AlexanderFurman/Final-Project/Demos/88c7a752-df2d-4189-9e73-a354138ea98a.jpg

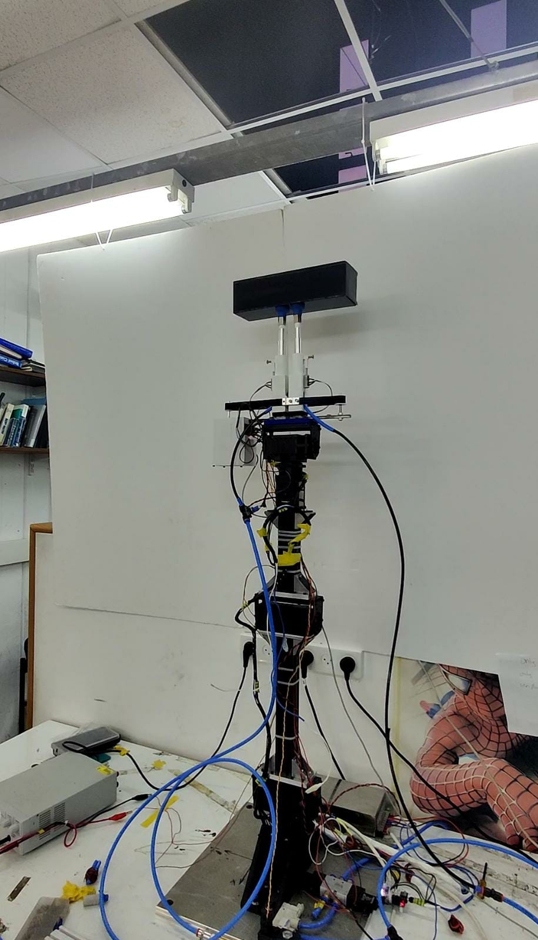
Demos/88c7a752-df2d-4189-9e73-a354138ea98a.jpg
