AlexanderFurman/Final-Project/Presentation/Alexander Furman Final Project Presentation.pptx

## Sensor integrated vacuum gripper

Alex Furman under supervision of prof. Rimon

Digital Connections

## Semester 1: Project description

- Create gripper with vacuum tech
- Integrate with ROS

Initial ideas

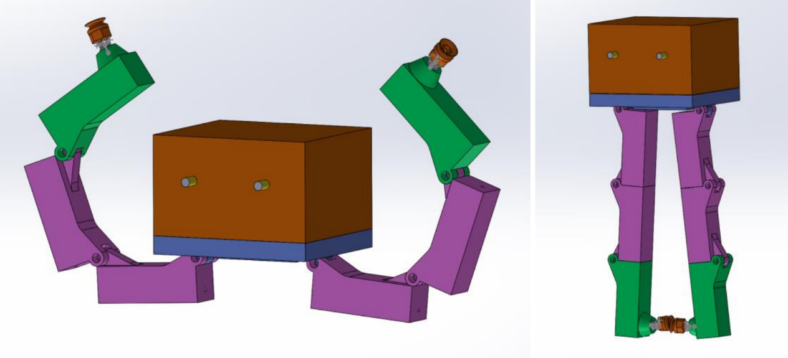
[picture p3: figure]

Final Product

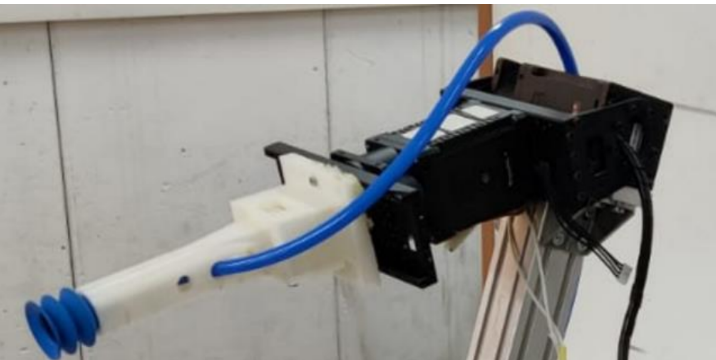
[picture p4: figure]
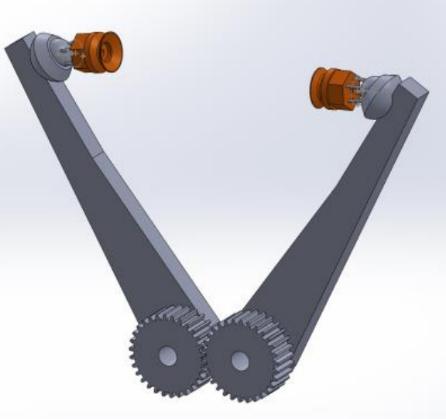
[picture p5: figure]
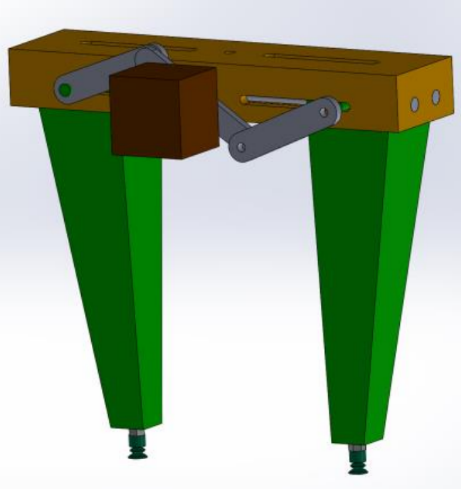
[picture p6: figure]

## Semester 1: System description

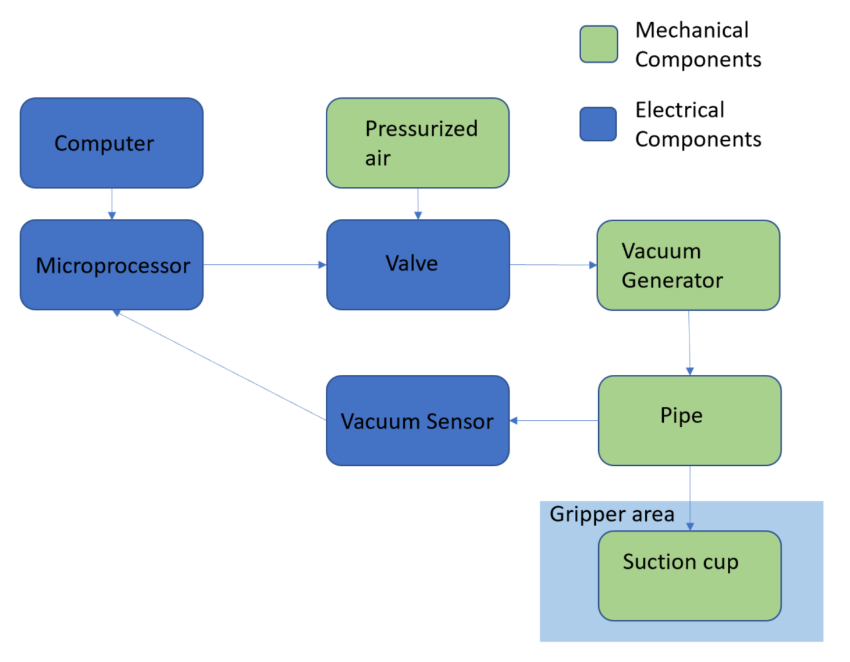
[picture p7: figure]

## Semester 1: design strengths + weaknesses

- Strengths:
  - Very compact
  - Strong suction
- Weaknesses:
  - Only handles smooth surfaces well
  - Requires very accurate placement
  - Does not handle torques well at suction cup

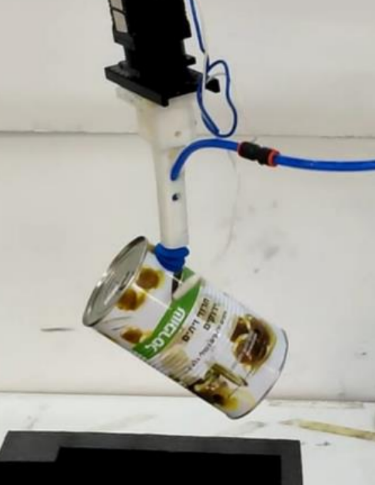
[picture p8: figure]

## Semester 2: Project description

  - Minimize design weaknesses
  - Improve gripper placement given inaccuracies in Computer Vision

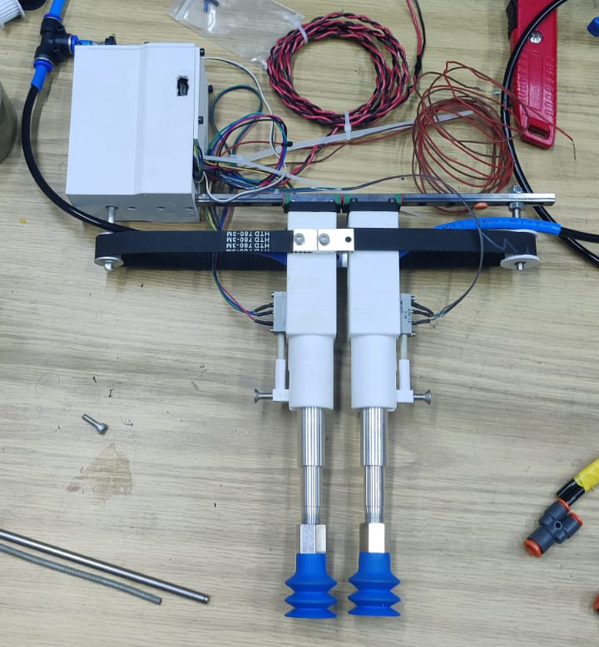
[picture p9: figure]
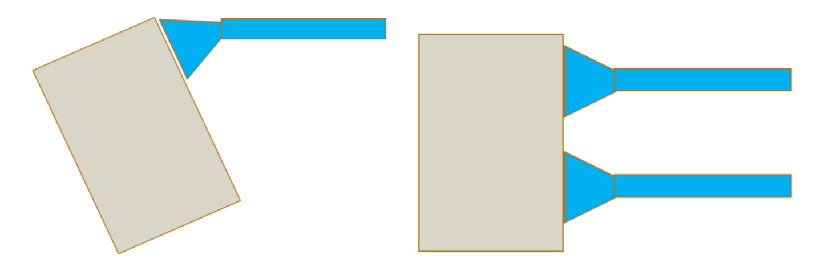
[picture p10: figure]
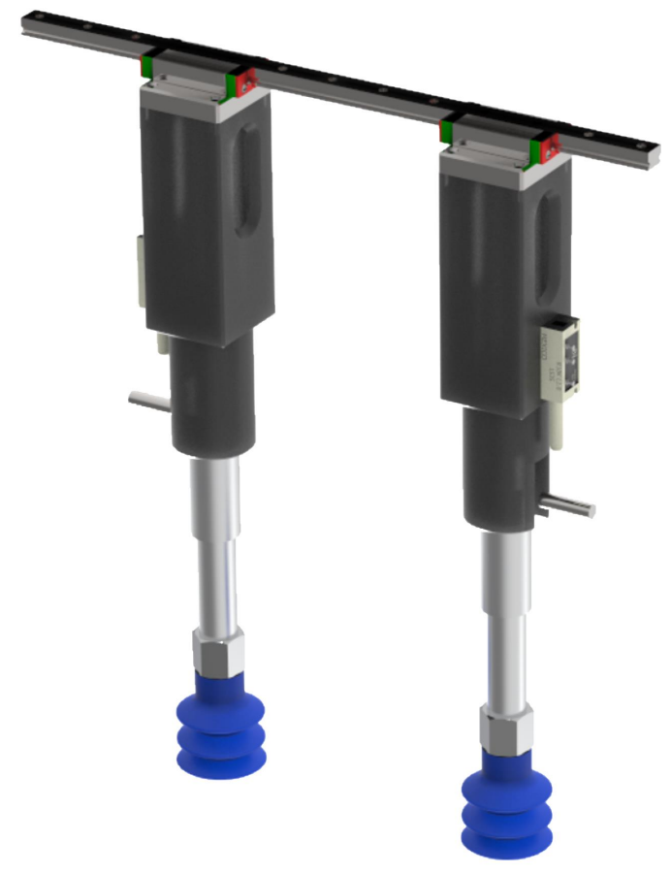
[picture p11: figure]
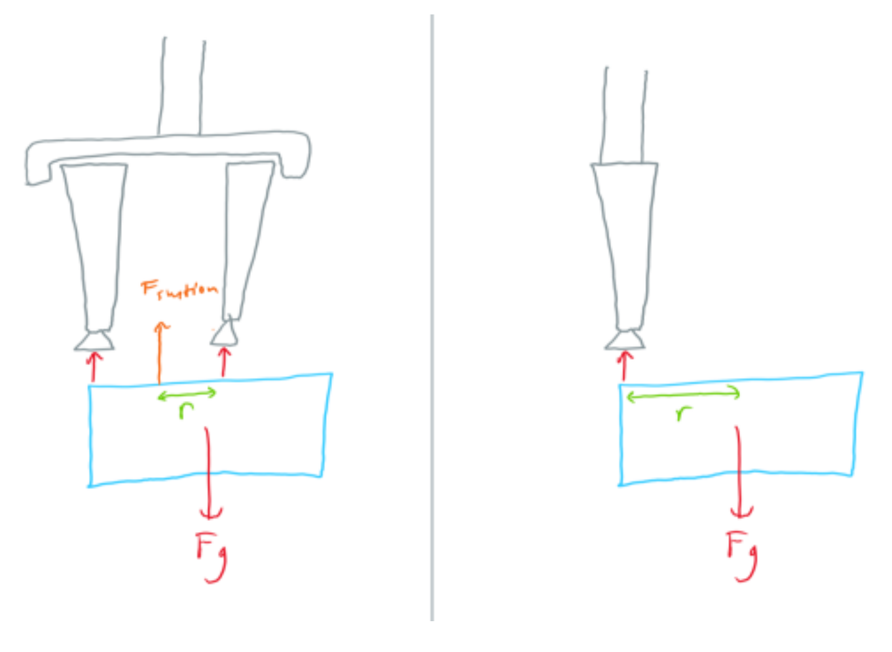
[picture p12: figure]

## Semester 2: Illustrations

  - Finger Design

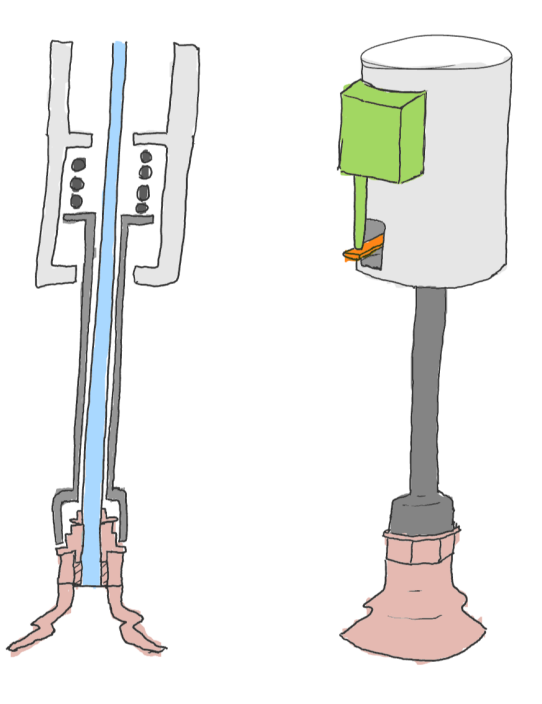
[picture p13: figure]

Belt Driven vs Lead-screw Driven

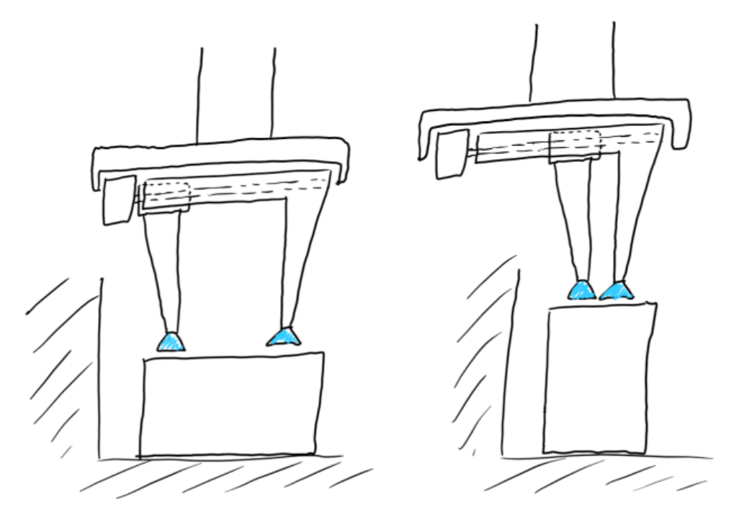
[picture p14: figure]
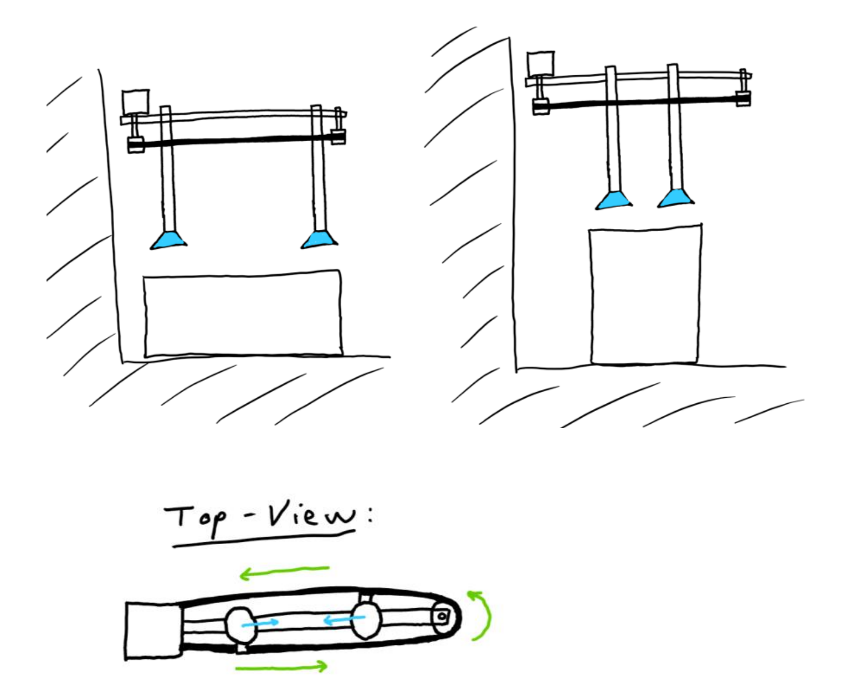
[picture p15: figure]

## Semester 2: design strengths + weaknesses

- Strengths:
  - Addresses torque issue from previous design
  - Now possible to create correction algorithms due to the potentiometers
- Weaknesses:
  - Force produced in each finger effectively halved (only one vacuum generator)
  - Bigger than last design
  - A lot more mechanical parts + electronics – harder maintenance
- Notes:
  - More testing should be done to determine if extra vacuum generator is necessary
  - Some components of the design can be improved in later iterations

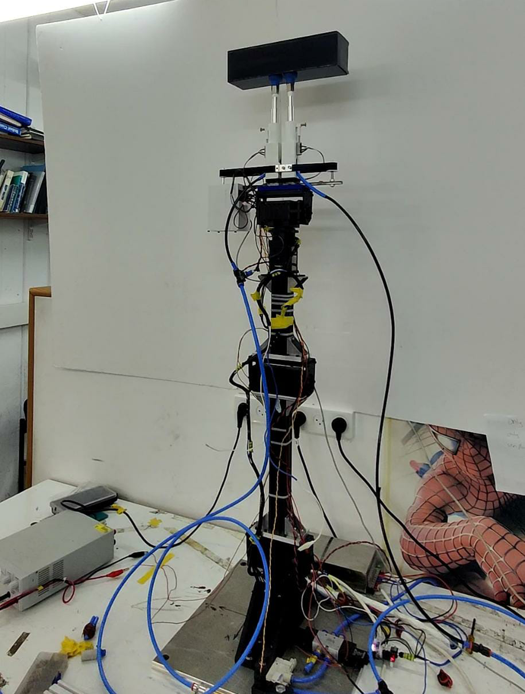
[picture p16: figure]

## Future work: algorithms

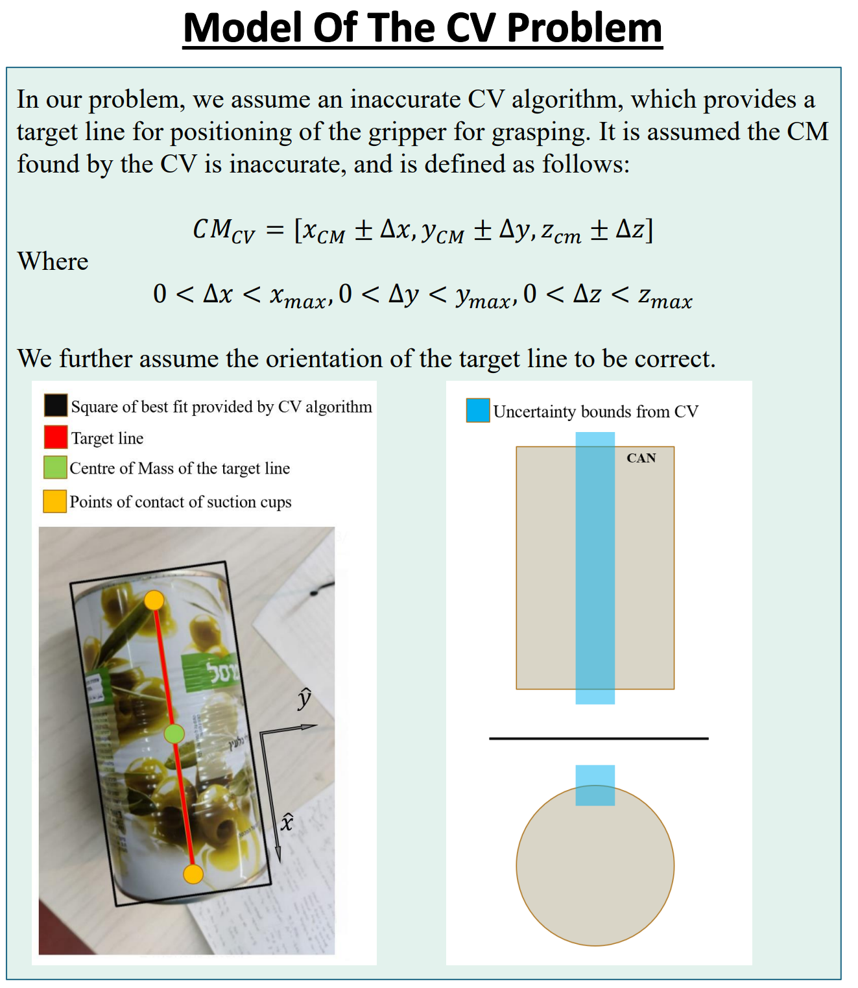
[picture p17: figure]
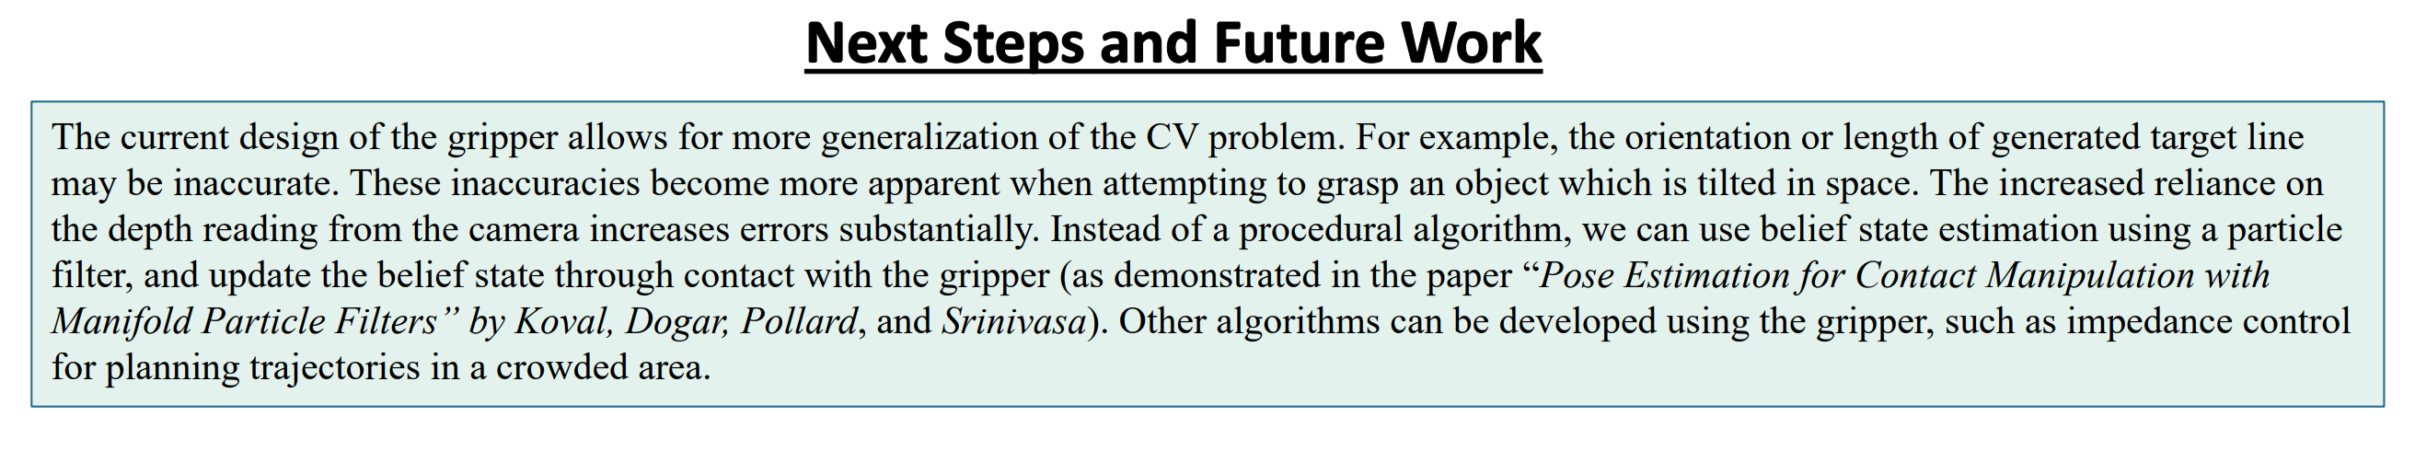
[picture p18: figure]
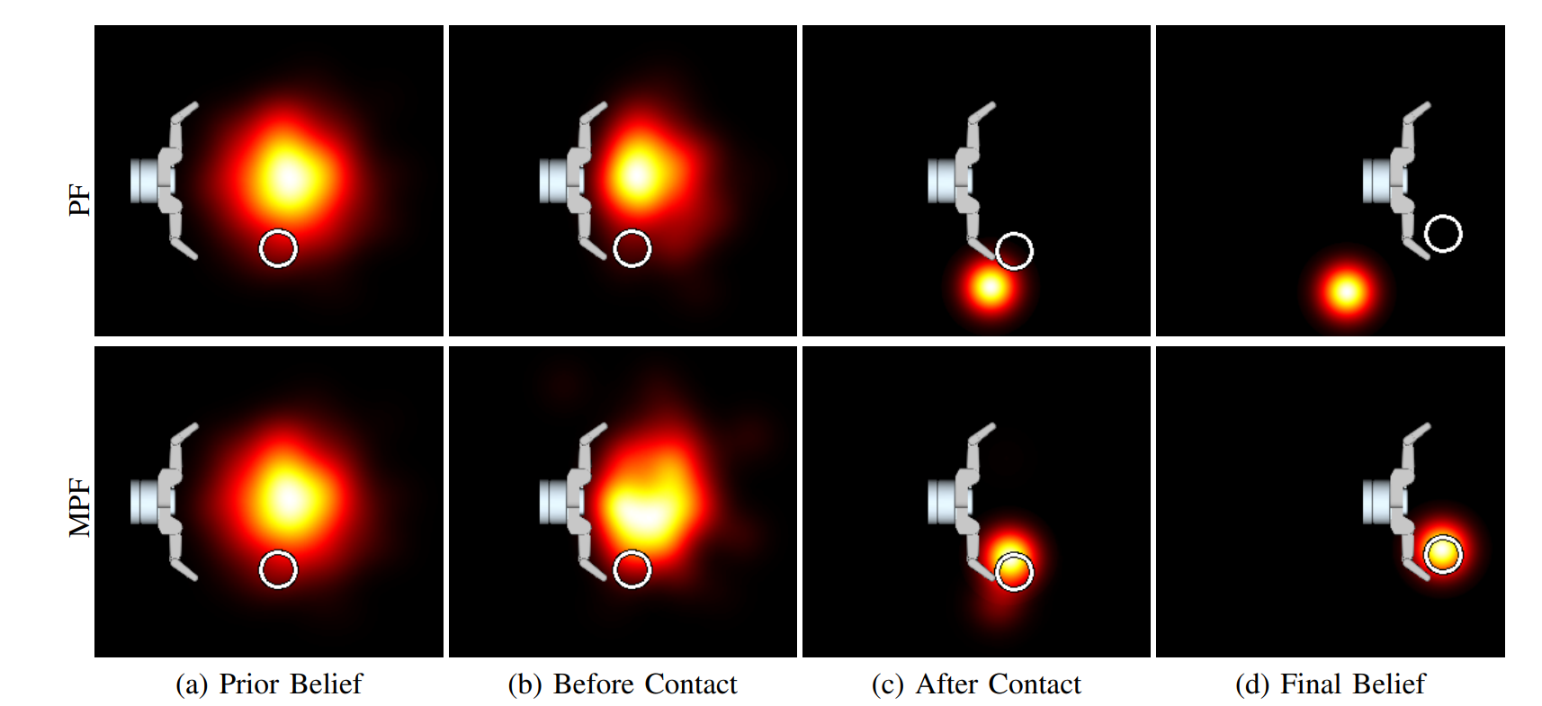
[picture p19: figure]
