AlexanderFurman/Final-Project/Electronics/Alex Furman - Electronics PDF.pdf

# Computer

# Pressurized

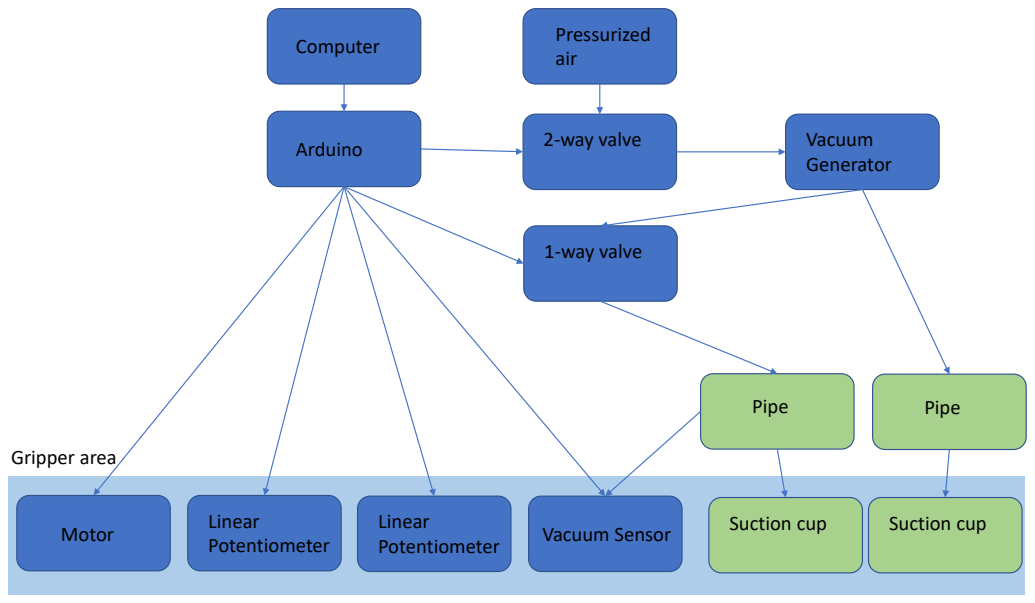
[picture p20: page 1]
air; Arduino; Linear Potentiometer; Linear; Potentiometer; Vacuum Sensor; Vacuum Generator; 2-way valve; 1-way valve; Suction cup; Gripper area; Motor; Pipe

# Gripper Schematic

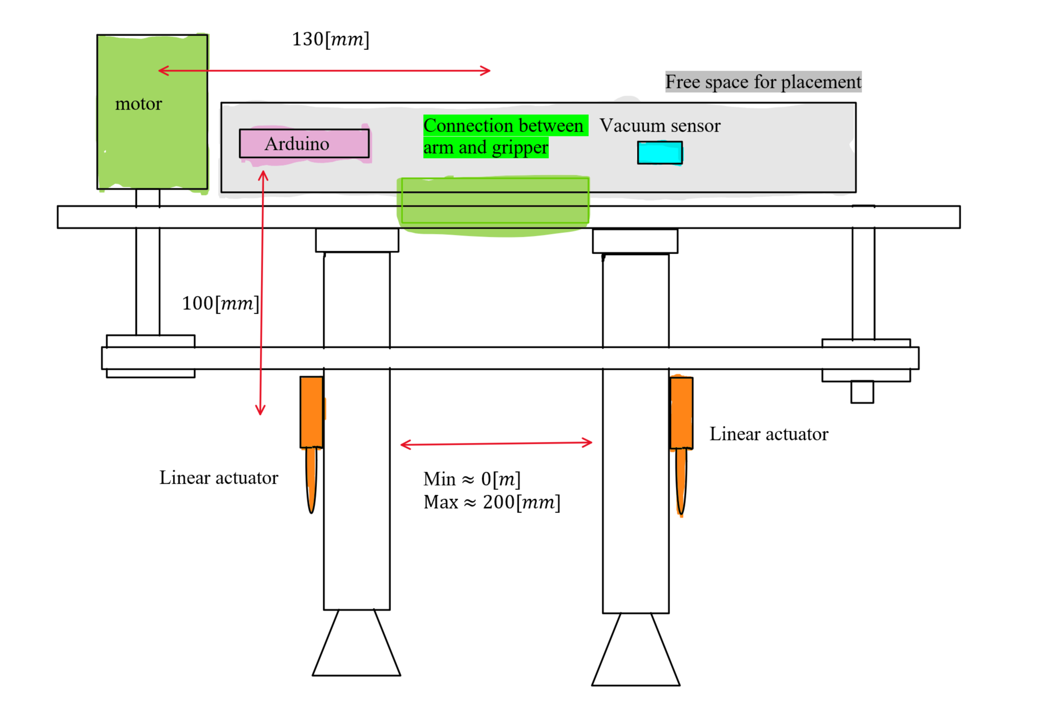
[picture p21: page 2]

# PCB casing dimensions

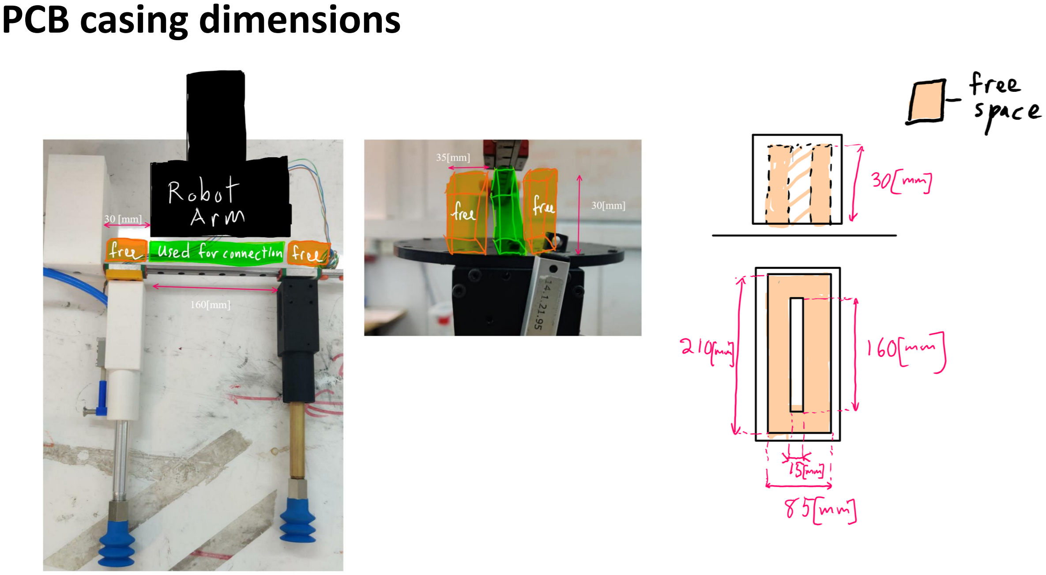
[picture p22: page 3]

# 2-way valve

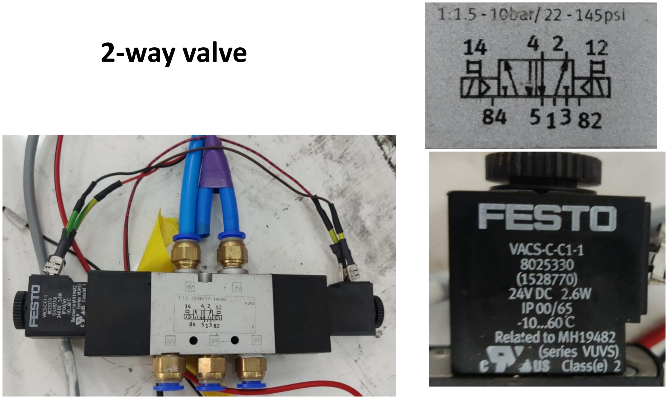
[picture p23: page 4]

# 1-way valve

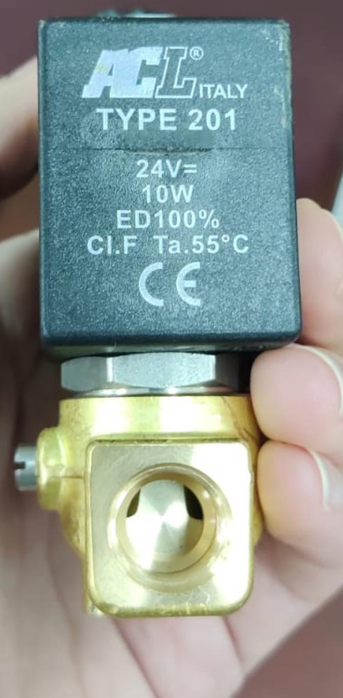
[picture p24: figure]
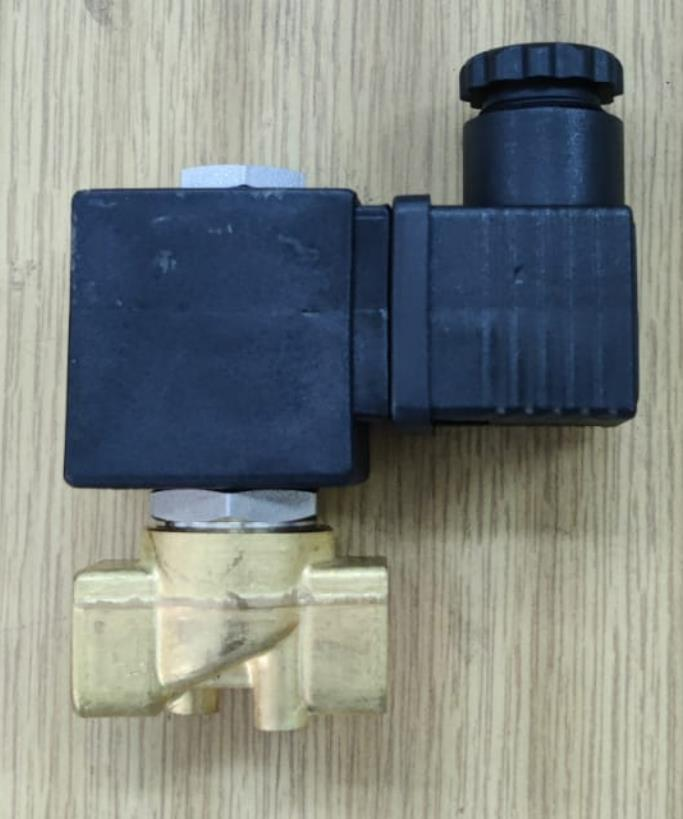
[picture p25: figure]

# Linear potentiometer

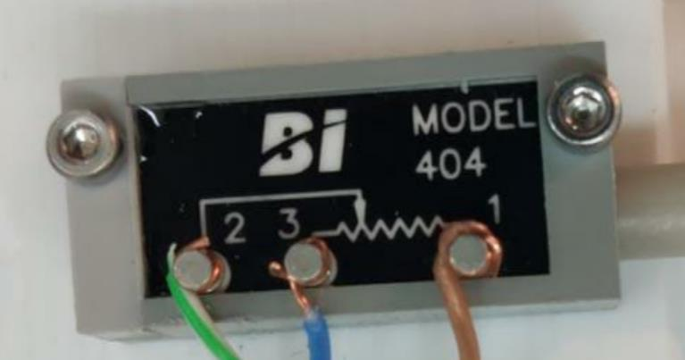
[picture p26: figure]

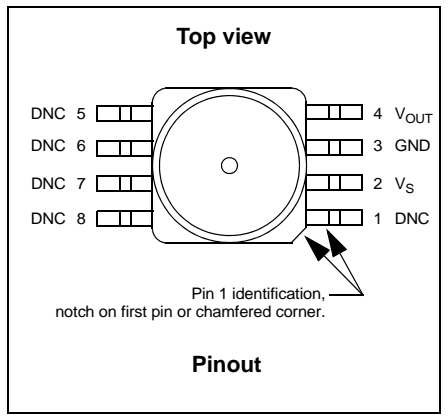
[picture p27: figure]
Top view; Pinout; Pin 1 identification, notch on first pin or chamfered corner.; DNC; GND; VOUT

Freescale reserves the right to change the detail specifications as may be required to permit improvements in the design of its products.

Freescale Semiconductor | Document Number: MPXV6115V
Data Sheet: Technical Data | Rev. 4.0, 09/2015

© 2009-2013, 2015 Freescale Semiconductor, Inc. All rights reserved.

MPXV6115V, -115 to 0 kPa, Gauge,

# and Absolute Pressure Sensor

The MPXV6115V series sensor integrates on-chip, bipolar op-amp circuitry and thin film resistor networks to provide a high output signal and temperature compensation. The small form factor and high reliability of on-chip integration make this pressure sensor a logical and economical choice for the system designer.
The MPXV6115V series piezoresistive transducer is a state-of-the-art, monolithic, signal conditioned, silicon pressure sensor. This sensor combines advanced micromachining techniques, thin film metallization, and bipolar semiconductor processing to provide an accurate, high level analog output signal that is proportional to applied pressure.
Features
- Improved accuracy at high temperature
- 1.5% maximum error from 0 to 85 °C
- Ideally suited for microprocessor- or microcontroller-based systems
- Temperature compensated from -40 to +125 °C
- Durable thermoplastic surface mount package
Typical applications
- Vacuum pump monitoring
- Brake booster monitoring

Ordering information
Device name | Shipping | Package | # of Ports | Pressure Type | Device Marking
None | Single | Dual | Gauge | Differential | Absolute
Small Outline Package
MPXV6115V6U | Rail | 98ASB17756C | • | | Vacuum/ Gauge | MPXV6115V
MPXV6115V6T1 | Tape and Reel | 98ASB17756C | • | | Vacuum/ Gauge | MPXV6115V
MPXV6115VC6U | Rail | 98ASB17757C | | • | Vacuum/ Gauge | MPXV6115V

# MPXV6115V

Small outline package

MPXV6115VC6U
Case 98ASB17757C

MPXV6115V6U/6T1
Case 98ASB17756C

MPXV6115V

Sensors
2 | Freescale Semiconductor, Inc.

## Related Documentation

The MPXV6115V device features and operations are described in a variety of reference manuals, user guides, and application notes. To find the most-current versions of these documents:
1. Go to the Freescale homepage at:
http://www.freescale.com/
2. In the Keyword search box at the top of the page, enter the device number MPXV6115V.
3. In the Refine Your Result pane on the left, click on the Documentation link.

## Contents

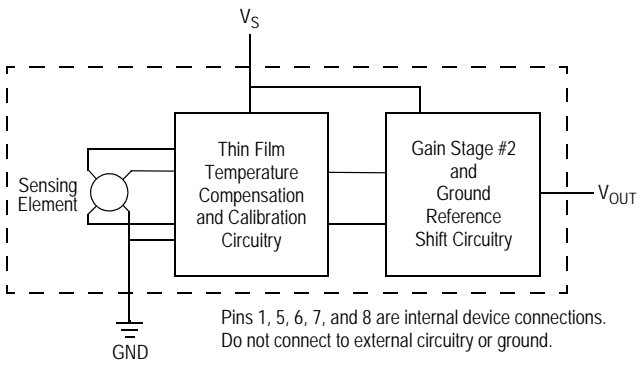
[picture p28: figure]
VOUT; Sensing Element; GND; Thin Film Temperature Compensation and Calibration Circuitry; Gain Stage #2 and Ground Reference Shift Circuitry

Freescale Semiconductor, Inc. | 3

## 1 General Description

## 1.1 Block diagram

Figure 1 shows a block diagram of the internal circuitry integrated on a pressure sensor chip.

Figure 1. Integrated pressure sensor block diagram

## 1.2 Pinout

Figure 2. Device pinout (top view)

Table 1. Pin functions

Pin | Name | Function
1 | DNC | Do not connect to external circuitry or ground. Pin 1 is notated by the notch in the lead or chamfered corner.
2 | VS | Voltage supply
3 | GND | Ground
4 | VOUT | Output voltage
5 | DNC | Do not connect to external circuitry or ground.
6 | DNC | Do not connect to external circuitry or ground.
7 | DNC | Do not connect to external circuitry or ground.
8 | DNC | Do not connect to external circuitry or ground.

Pins 1, 5, 6, 7, and 8 are internal device connections. Do not connect to external circuitry or ground.

Pin 1 identification,
notch on first pin or chamfered corner.

1

2

3

5 | 4

6

7

8

DNC

DNC

DNC | DNC
DNC | VS GND

VOUT

4 | Freescale Semiconductor, Inc.

## 2 Mechanical and Electrical Specifications

## 2.1 Maximum ratings

## 2.2 Operating characteristics

Table 2. Maximum ratings⁽¹⁾

1. Exposure beyond the specified limits may cause permanent damage or degradation to the device.
Parametrics | Symbol | Value | Units
Maximum pressure (P1 > P2) | Pmax | 400 | kPa
Storage temperature | Tstg | -40 to +125 | °C
Operating temperature | TA | -40 to +125 | °C
Output source current @ full-scale output⁽²⁾ | Io+ | 0.5 | mAdc
Output sink current @ minimum pressure offset⁽²⁾ | Io- | -0.5 | mAdc
2. Maximum output current is controlled by effective impedance from VOUT to GND or VOUT to VS in the application circuit.

Table 3. Operating characteristics (VS = 5.0 VDC, TA = 25 °C unless otherwise noted, P1 > P2.)

Characteristic | Symbol | Min | Typ | Max | Unit
Pressure range | POP | –115 | — | 0 | kPa
Supply voltage⁽¹⁾ | VS | 4.75 | 5.0 | 5.25 | VDC
Supply current | Io | — | 6.0 | 10 | mAdc
Full-scale output⁽²⁾ (0 to 85 °C), @ VS = 5.0 Volts | VFSO | 4.534 | 4.6 | 4.665 | VDC
Full-scale span⁽³⁾ (0 to 85 °C), @ VS = 5.0 Volts | VFSS | — | 4.4 | — | VDC
Accuracy⁽⁴⁾ (0 to 85 °C) | — | — | — | ±1.5 | %VFSS
Sensitivity | V/P | — | 38.26 | — | mV/kPa
Response time⁽⁵⁾ | tR | — | 1.0 | — | ms
Warm-up time⁽⁶⁾ | — | — | 20 | — | ms
Offset stability⁽⁷⁾ | — | — | ±0.5 | — | %VFSS
1. Device is ratiometric within this specified excitation range.
2. Full-scale output (VFSO) is defined as the output voltage at the maximum or full rated pressure.
3. Full-scale span (VFSS) is defined as the algebraic difference between the output voltage at full rated pressure and the output voltage at the minimum rated pressure.
4. Accuracy is the deviation in actual output from nominal output over the entire pressure range and temperature range as a percent of span at 25 °C due to all sources of error including the following:
Linearity: Output deviation from a straight line relationship with pressure over the specified pressure range.
Temperature hysteresis:Output deviation at any temperature within the operating temperature range, after the temperature is cycled to and from the minimum or maximum operating temperature points, with zero differential pressure applied. Pressure hysteresis: Output deviation at any pressure within the specified range, when this pressure is cycled to and from minimum or maximum rated pressure at 25 °C
TcSpan: Output deviation over the temperature range of 0 to 85 °C, relative to 25 °C.
TcOffset: Output deviation with minimum pressure applied, over the temperature range of 0 to 85 °C, relative to 25 °C.
5. Response time is defined as the time for the incremental change in the output to go from 10% to 90% of its final value when subjected to a specified step change in pressure.
6. Warm-up time is defined as the time required for the product to meet the specified output voltage after the pressure has been stabilized.
7. Offset stability is the product's output deviation when subjected to 1000 cycles of Pulsed Pressure, Temperature Cycling with Bias Test.

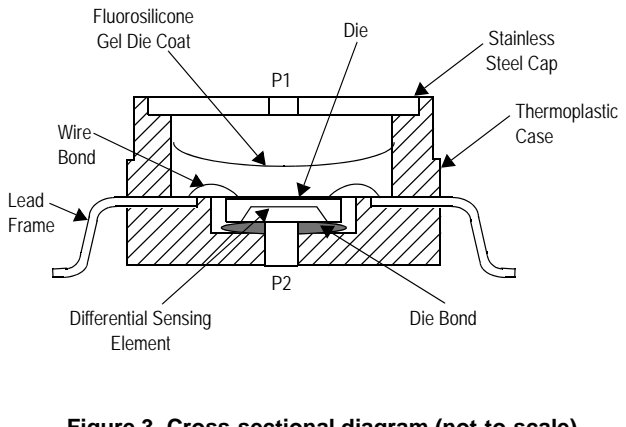
[picture p29: figure]
Fluorosilicone Gel Die Coat; Differential Sensing Element; Stainless Steel Cap P1; Die Bond; Die; Thermoplastic Case; Lead Frame; Wire Bond
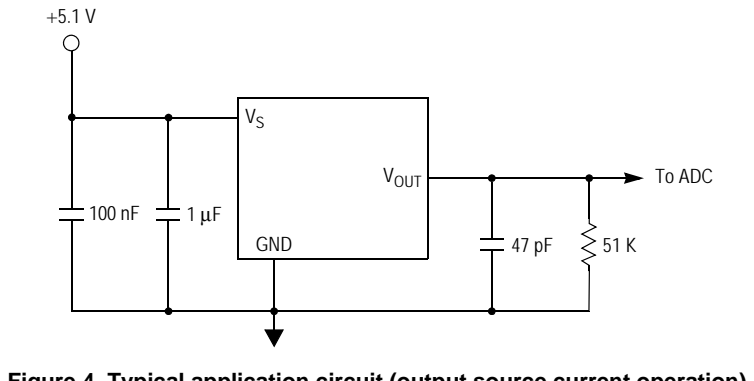
[picture p30: figure]
GND; VOUT; To ADC

Freescale Semiconductor, Inc. | 5

## 3 On-chip Temperature Compensation and Calibration

Figure 3 illustrates the absolute sensing chip in the basic small outline chip carrier ().
Figure 4 shows a typical application circuit (output source current operation).
Figure 5 shows the sensor output signal relative to pressure input. Typical minimum and maximum output curves are shown for operation over 0 to 85 °C temperature range. The output will saturate outside of the rated pressure range.
A fluorosilicone gel isolates the die surface and wire bonds from the environment, while allowing the pressure signal to be transmitted to the silicon diaphragm. The MPXV6115V series pressure sensor operating characteristics, internal reliability and qualification tests are based on use of dry air as the pressure media. Media other than dry air may have adverse effects on sensor performance and long-term reliability. Contact the factory for information regarding media compatibility in your application.
The MPXV6115V is optimized to perform in vacuum pressures applied to port P1. The sensor is calibrated and temperature compensated to give a positive electrical output upon measuring a vacuum pressure up to the rated pressure of up to -115 kPa where the output will be the full-scale voltage listed in Table 3.

Figure 3. Cross-sectional diagram (not-to-scale)

Figure 4. Typical application circuit (output source current operation)

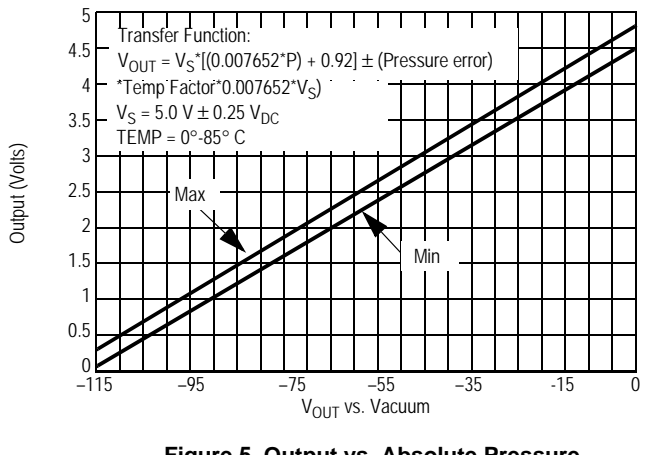
[picture p31: figure]
Transfer Function:; VOUT vs. Vacuum; Output (Volts); TEMP = 0°-85° C; Min; Max

6 | Freescale Semiconductor, Inc.

Figure 5. Output vs. Absolute Pressure

Figure 6. Transfer function

Figure 7. Temperature error band

Figure 8. Pressure error band

VOUT = VS*[(0.007652*P) + 0.92] ± (Pressure error) *Temp Factor*0.007652*VS) VS = 5.0 V ± 0.25 VDC

Nominal Transfer Value: VOUT = VS x (0.007652 x P + 0.92) ± (Pressure Error x Temp. Factor x 0.007652 x VS) VS = 5.0 ± 0.25 VDC

Temperature in °C

4.0

3.0

2.0

0.0

1.0

-40 | -20 | 0 | 20 | 40 | 60 | 13012010080
–40 | 3
0 to 85 | 1
125 | 2

NOTE: The temperature multiplier is a linear response from 0 to –40 °C and from 85 to 125 °C.

140

Temp. Multiplier

Pressure in kPa
(below atmospheric)

1.950

1.725

1.500

-1.500

-1.725

-1.950

0
-115 | -100 | -85 | -45 | -30 | -15 | 0

Pressure Error (kPa)

Pressure Error (max)

Error Limits for Pressure

-115 to 0 kPa ± 1.725 kPa

-1.500

## 4 Package Information

## 4.1 Minimum recommended footprint for surface mounted applications

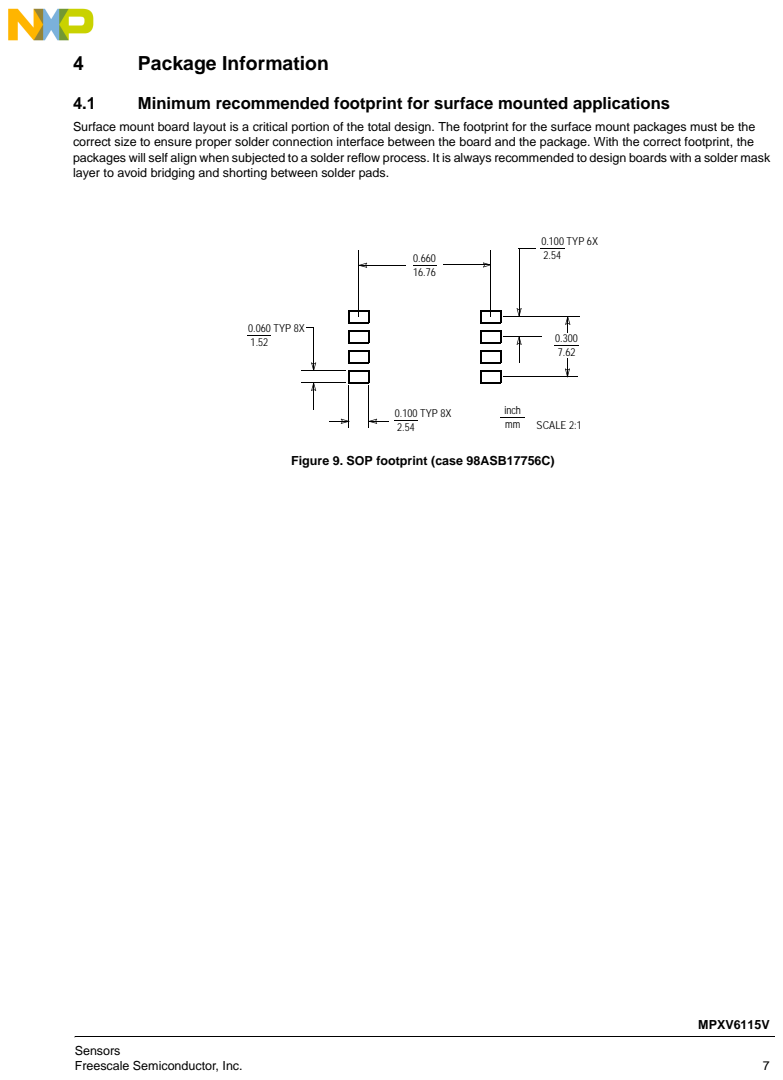
[picture p32: page 13]
Freescale Semiconductor, Inc.; 0.060 TYP 8X 1.52; 0.100 TYP 8X 2.54; 0.100 TYP 6X 2.54; inch mm SCALE 2:1

Surface mount board layout is a critical portion of the total design. The footprint for the surface mount packages must be the
correct size to ensure proper solder connection interface between the board and the package. With the correct footprint, the
packages will self align when subjected to a solder reflow process. It is always recommended to design boards with a solder mask
layer to avoid bridging and shorting between solder pads.

Figure 9. SOP footprint (case 98ASB17756C)

## 4.2 Package Dimensions

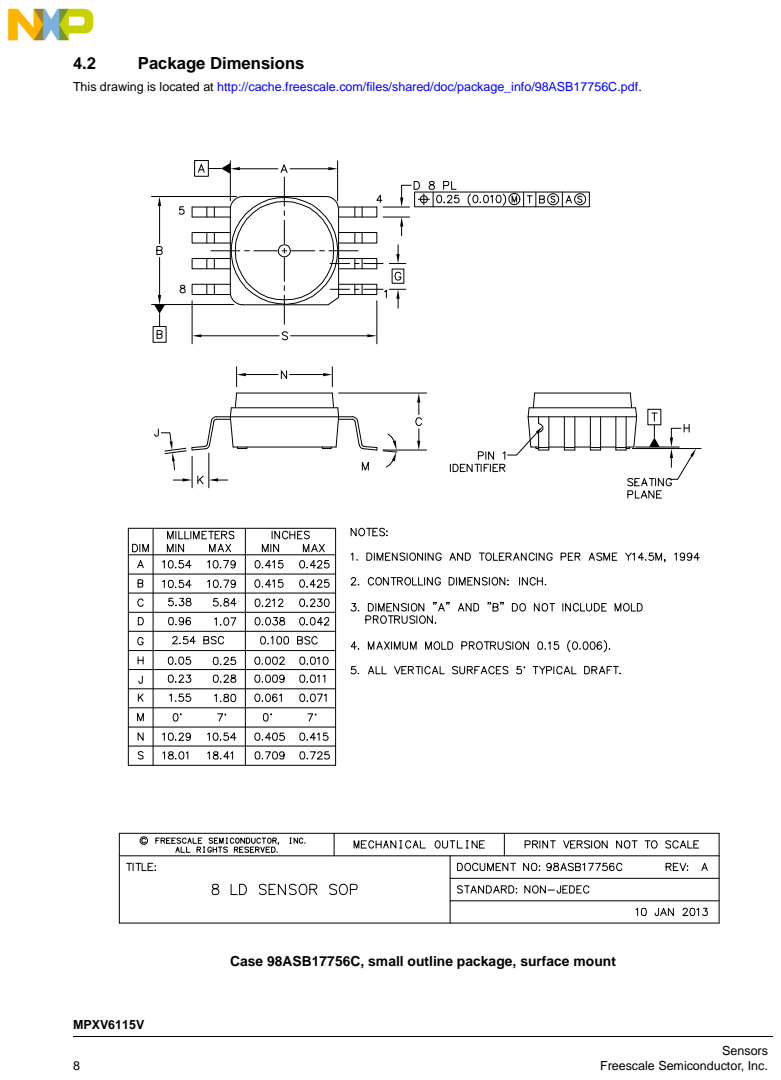
[picture p33: page 14]
Freescale Semiconductor, Inc.

This drawing is located at http://cache.freescale.com/files/shared/doc/package_info/98ASB17756C.pdf.

Case 98ASB17756C, small outline package, surface mount

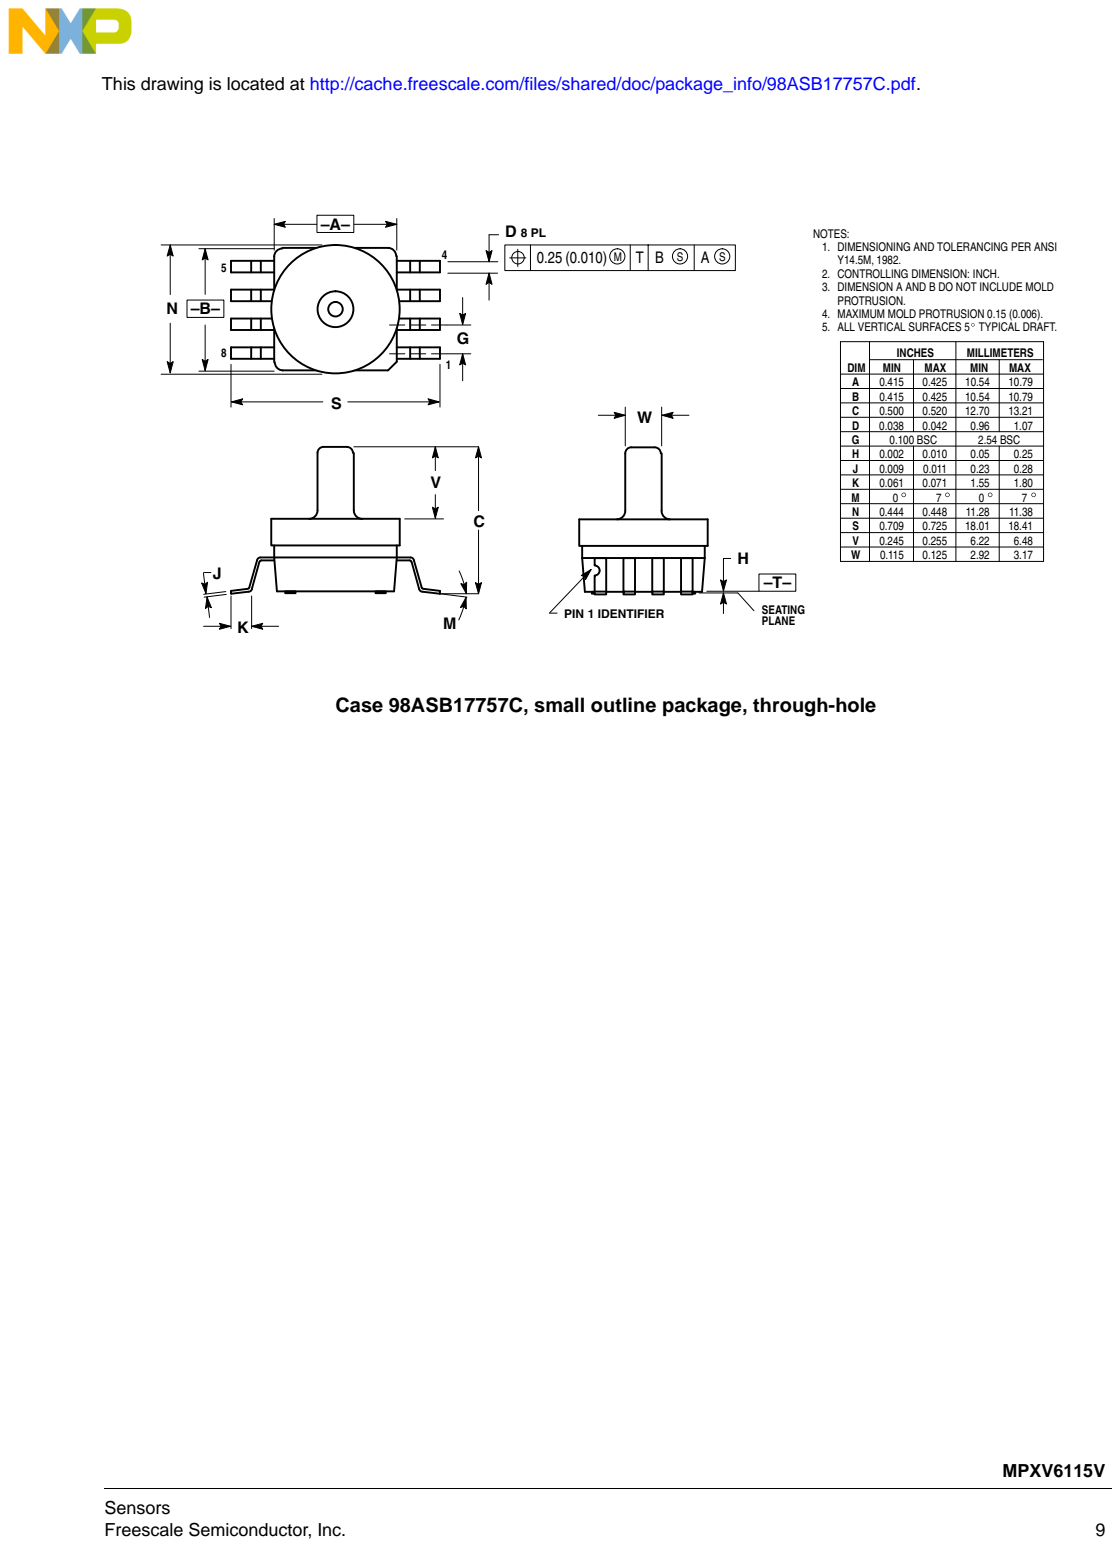
[picture p34: page 15]
Freescale Semiconductor, Inc.; K PIN 1 IDENTIFIER; SEATING PLANE

This drawing is located at http://cache.freescale.com/files/shared/doc/package_info/98ASB17757C.pdf.

NOTES:
1. DIMENSIONING AND TOLERANCING PER ANSI
2. CONTROLLING DIMENSION: INCH.
3. DIMENSION A AND B DO NOT INCLUDE MOLD
PROTRUSION.
4. MAXIMUM MOLD PROTRUSION 0.15 (0.006).
5. ALL VERTICAL SURFACES 5 TYPICAL DRAFT.

DIM | INCHES | MILLIMETERS
MIN | MAX | MIN | MAX
A | 0.415 | | 10.54 | 10.79 0.425
B | 0.415 | | 10.54 | 10.79 0.425
C | 0.500 | | 12.70 | 13.21 0.520
D | 0.038 | | 0.96 | 1.07 0.042
G | 0.100 BSC | | 2.54 BSC
H | 0.002 | 0.010 | 0.05 | 0.25
J | 0.009 | 0.011 | 0.23 | 0.28
K | 0.061 | 0.071 | 1.55 | 1.80
N | 0.444 | 0.448 | 11.28 | 11.38
S | 0.709 | 0.725 | 18.01 | 18.41
V | 0.245 | 0.255 | 6.22 | 6.48
W | 0.115 | 0.125 | 2.92 | 3.17

Case 98ASB17757C, small outline package, through-hole

10 | Freescale Semiconductor, Inc.

## 5 Revision History

Table 4. Revision history

Revision number | Revision date | Description of changes
2 | 10/2012 | • Added devices MPXB611V6U and MPX6115V6T1 and corresponding package, 482.
3 | 01/2013 | • Corrected psi range on page 1, device description box
4.0 | 09/2015 | • Updated format. • Corrected figure 4. • Added vacuum pressure information to section 3. • Updated case outline 98ASB17756C with current version. • Deleted obsolete device MPXV6115VC6T1.

Document Number: MPXV6115V Rev. 4.0
09/2015

Information in this document is provided solely to enable system and software

implementers to use Freescale products. There are no express or implied copyright

licenses granted hereunder to design or fabricate any integrated circuits based on the

information in this document.

Freescale reserves the right to make changes without further notice to any products

herein. Freescale makes no warranty, representation, or guarantee regarding the

suitability of its products for any particular purpose, nor does Freescale assume any

liability arising out of the application or use of any product or circuit, and specifically

disclaims any and all liability, including without limitation consequential or incidental

damages. “Typical” parameters that may be provided in Freescale data sheets and/or

specifications can and do vary in different applications, and actual performance may

vary over time. All operating parameters, including “typicals,” must be validated for each

customer application by customer’s technical experts. Freescale does not convey any

license under its patent rights nor the rights of others. Freescale sells products pursuant

to standard terms and conditions of sale, which can be found at the following address:

freescale.com/salestermsandconditions.

How to Reach Us:

Home Page:
freescale.com

Web Support:
freescale.com/support

Freescale and the Freescale logo are trademarks of Freescale Semiconductor, Inc.,

Reg. U.S. Pat. & Tm. Off. All other product or service names are the property of their

respective owners.

© 2009-2013, 2015 Freescale Semiconductor, Inc.
