AlexanderFurman/Final-Project/Electronics/Alex Furman - Electronics.pdf

Computer; Pressurized air; Arduino; Linear Potentiometer; Linear; Potentiometer; Vacuum Sensor; Vacuum Generator; 2-way valve; 1-way valve; Suction cup; Gripper area; Motor; Pipe

# Gripper Schematic


# PCB casing dimensions


# 2-way valve


# 1-way valve


# Linear potentiometer
