AlexanderFurman/Final-Project/Presentation/final_presentation.pdf

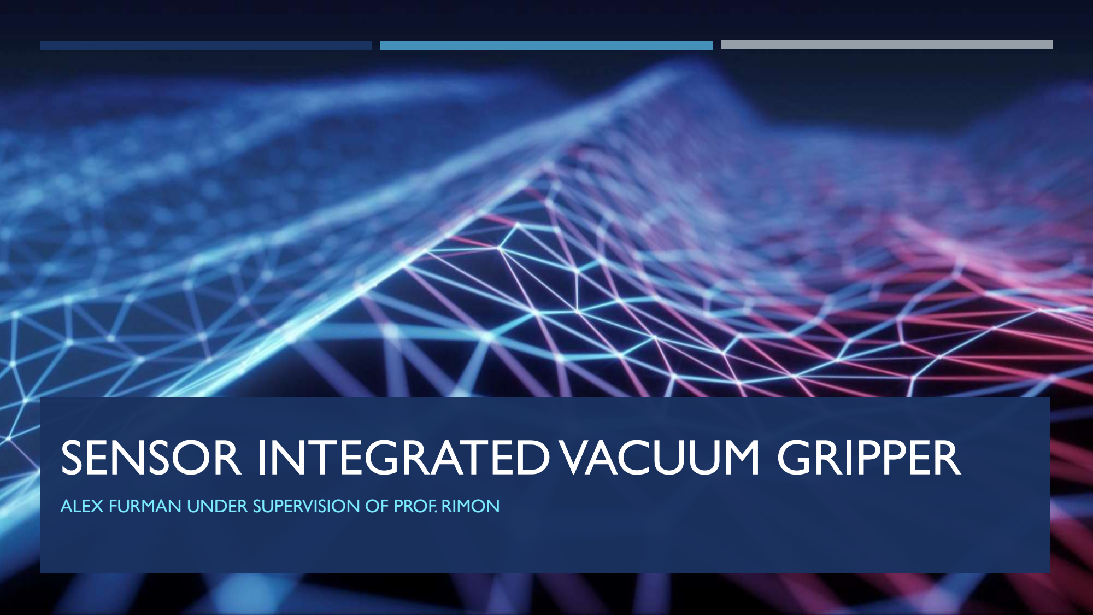
[picture p35: page 1]

# SENSOR INTEGRATED VACUUM GRIPPER

ALEX FURMAN UNDER SUPERVISION OF PROF. RIMON

# SEMESTER 1: PROJECT DESCRIPTION

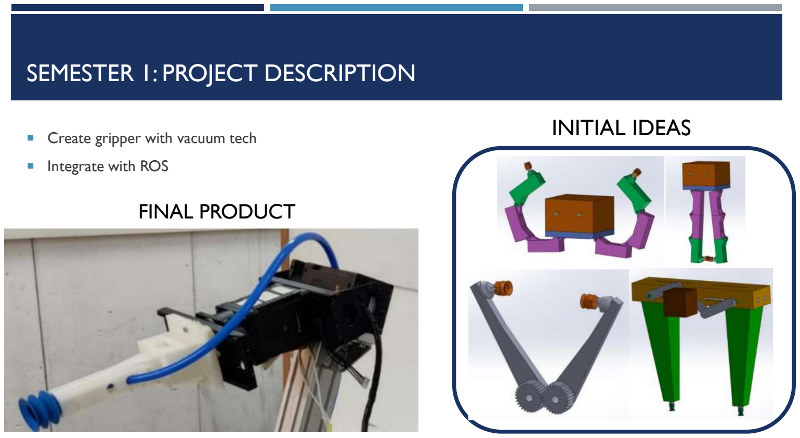
[picture p36: page 2]

- Create gripper with vacuum tech
- Integrate with ROS

## INITIAL IDEAS

## FINAL PRODUCT

# SEMESTER 1: SYSTEM DESCRIPTION

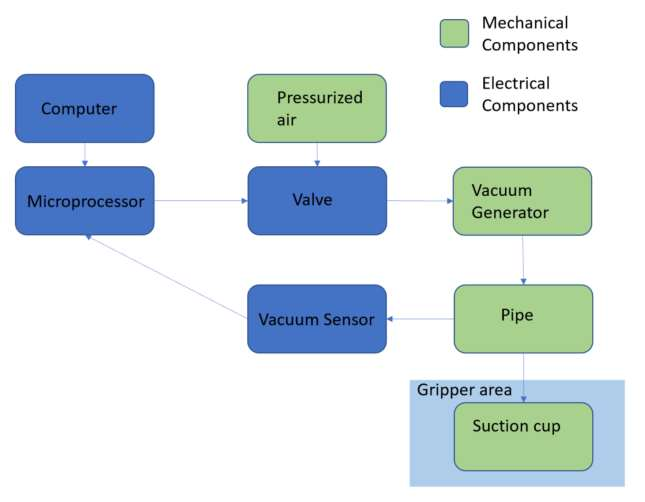
[picture p37: figure]

# SEMESTER 1: DESIGN STRENGTHS + WEAKNESSES

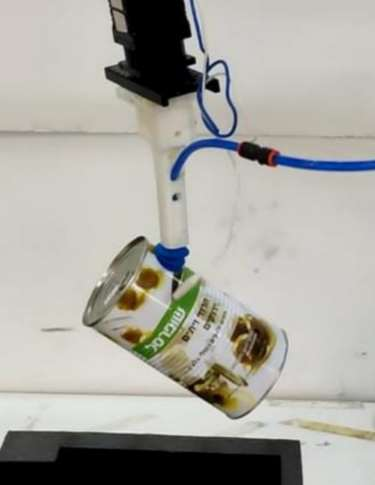
[picture p38: figure]

- Strengths:
- Very compact
- Strong suction
- Weaknesses:
- Only handles smooth surfaces well
- Requires very accurate placement
- Does not handle torques well at suction cup

# SEMESTER 2: PROJECT DESCRIPTION

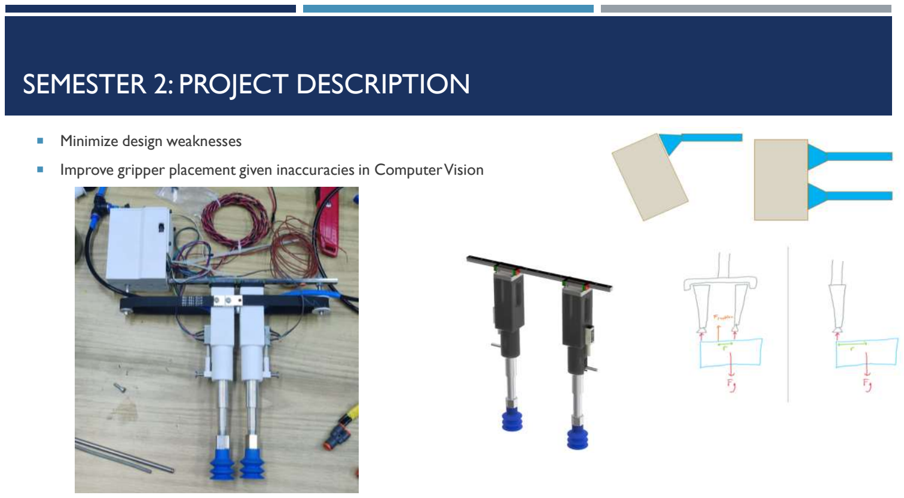
[picture p39: page 5]

- Minimize design weaknesses
- Improve gripper placement given inaccuracies in Computer Vision

# SEMESTER 2: ILLUSTRATIONS

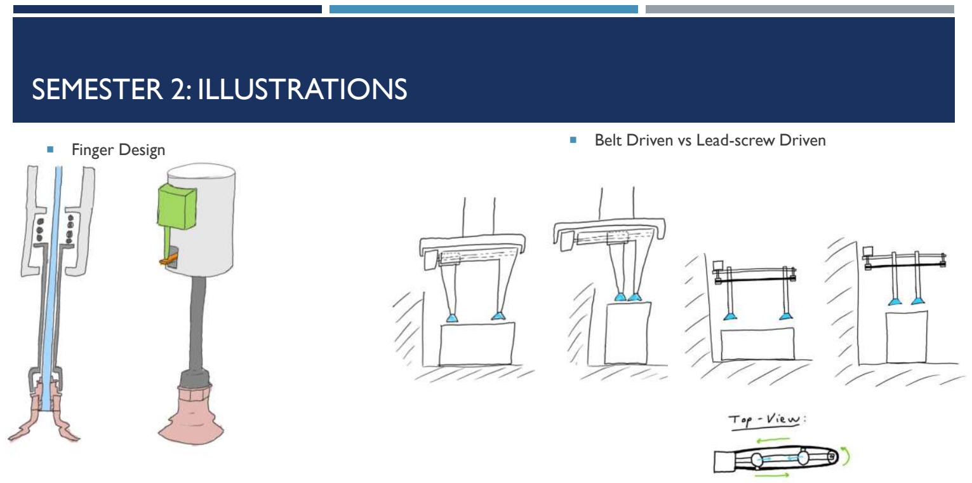
[picture p40: page 6]

- Finger Design
- Belt Driven vs Lead-screw Driven

# SEMESTER 2: DESIGN STRENGTHS + WEAKNESSES

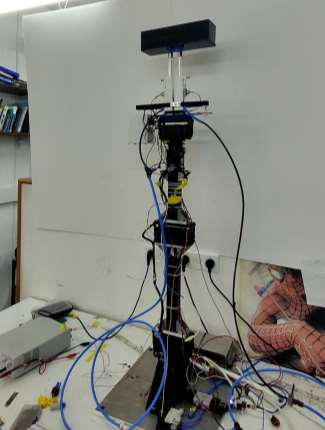
[picture p41: figure]

- Strengths:
- Addresses torque issue from previous design
- Now possible to create correction algorithms due to the potentiometers
- Weaknesses:
- Force produced in each finger effectively halved (only one vacuum generator)
- Bigger than last design
- A lot more mechanical parts + electronics – harder maintenance
- Notes:
- More testing should be done to determine if extra vacuum generator is necessary
- Some components of the design can be improved in later iterations

# FUTURE WORK: ALGORITHMS

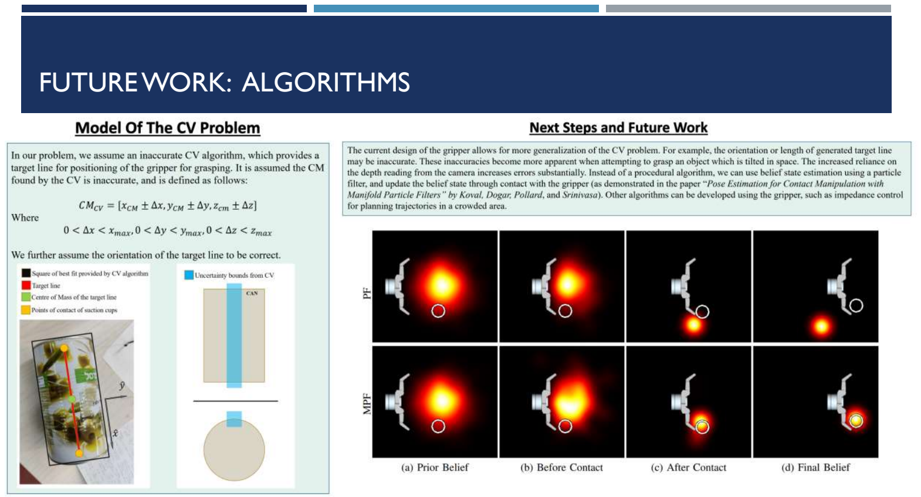
[picture p42: page 8]
