AlexanderFurman/Final-Project/Research/Doc2.docx

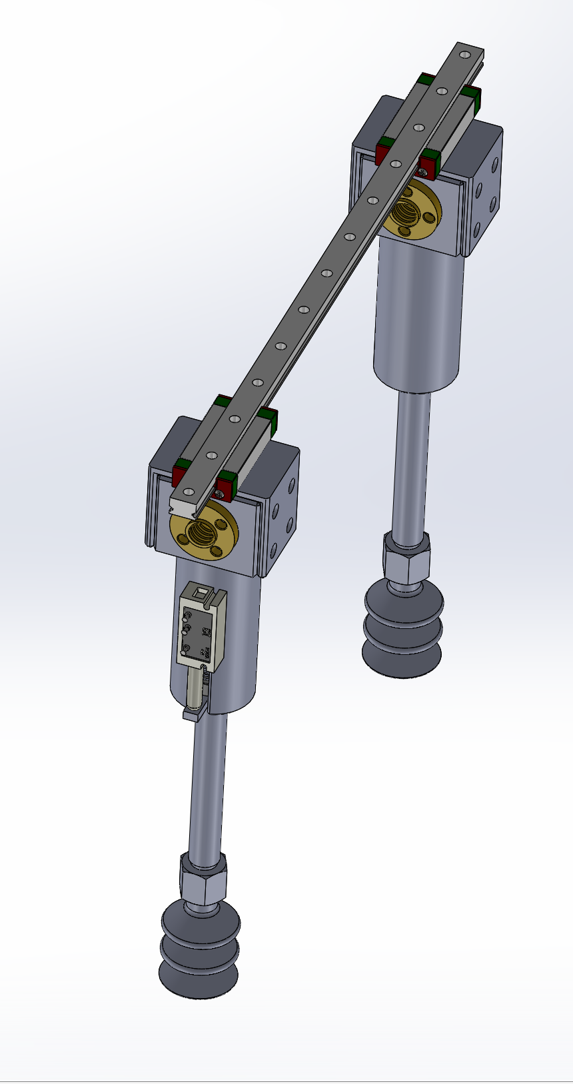
[picture p43: figure]
