AlexanderFurman/Final-Project/Research/Doc1.pdf

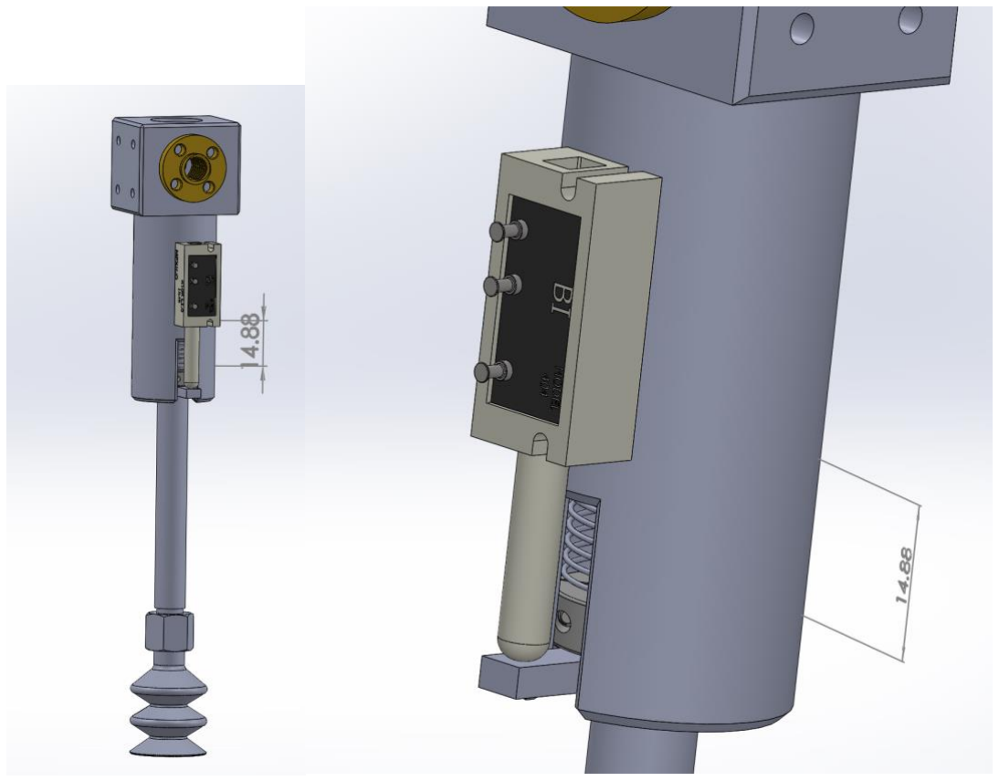
[picture p44: figure]

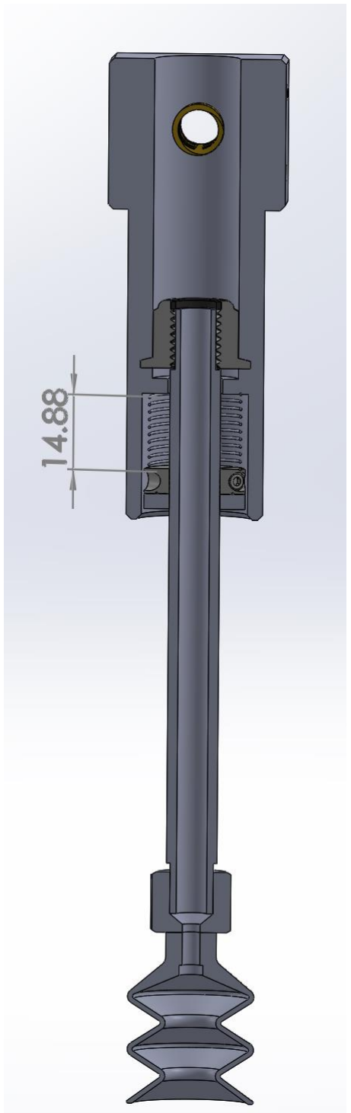
[picture p45: figure]
