AlexanderFurman/Final-Project/Electronics/Circuitry.pdf

## 24 Volt

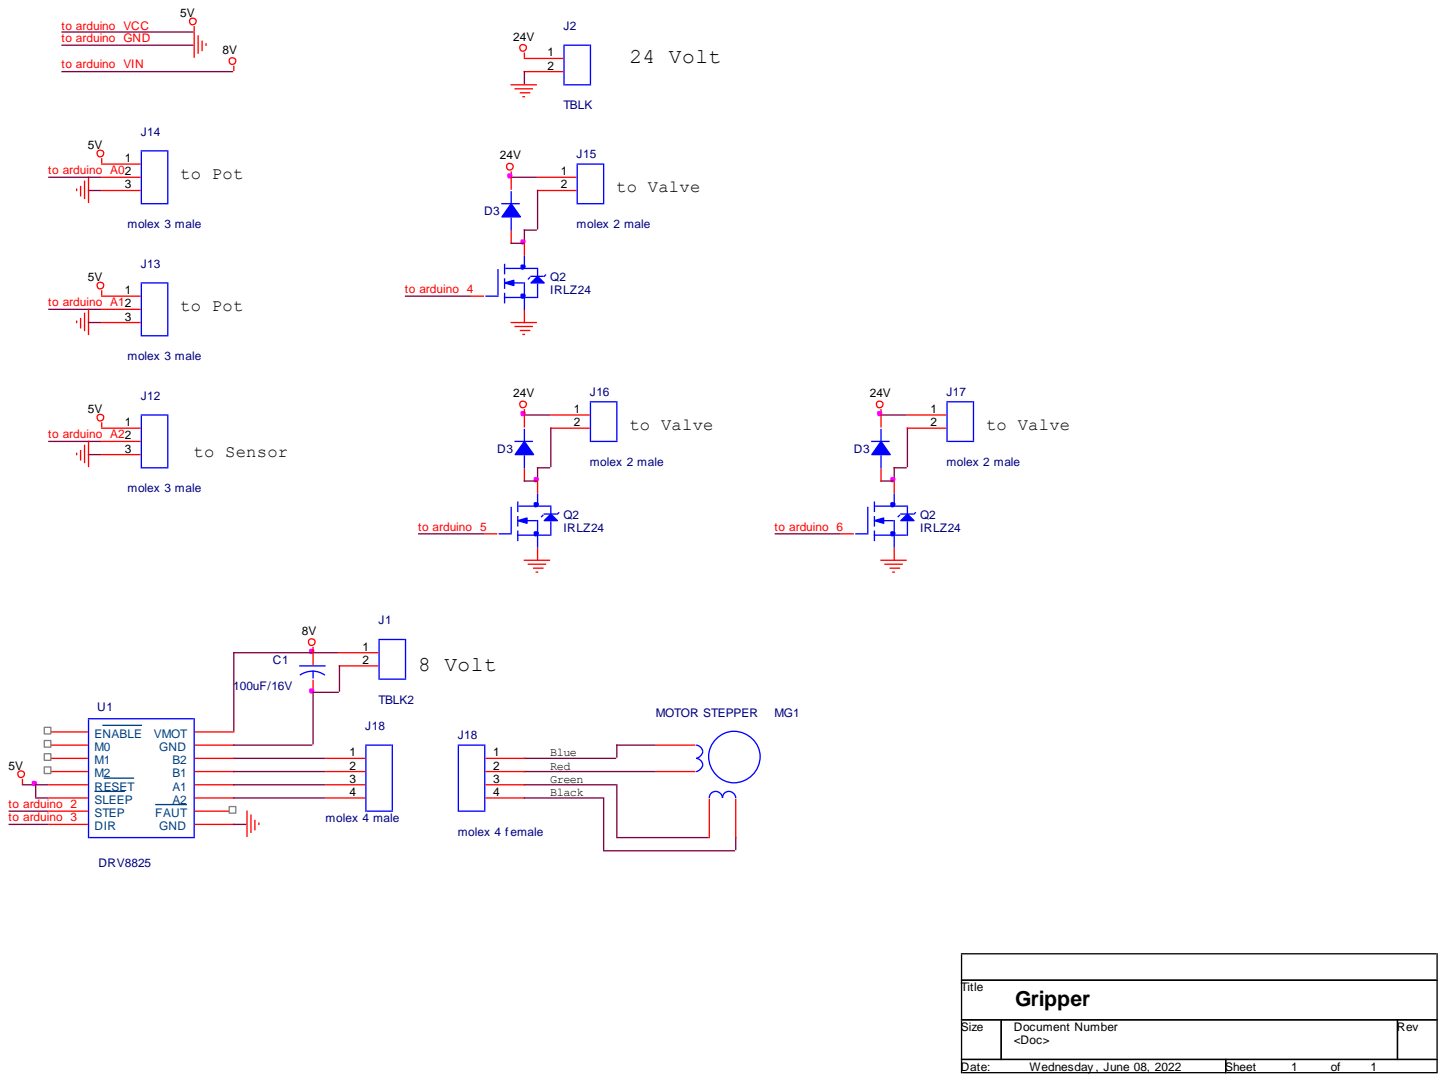
[picture p46: page 1]

Size | Document Number <Doc> | Rev

Date: Wednesday , June 08, 2022 | Sheet 1 of 1
