AlexanderFurman/Final-Project/Manufacturing/A3 Vacuum Rod New.pdf

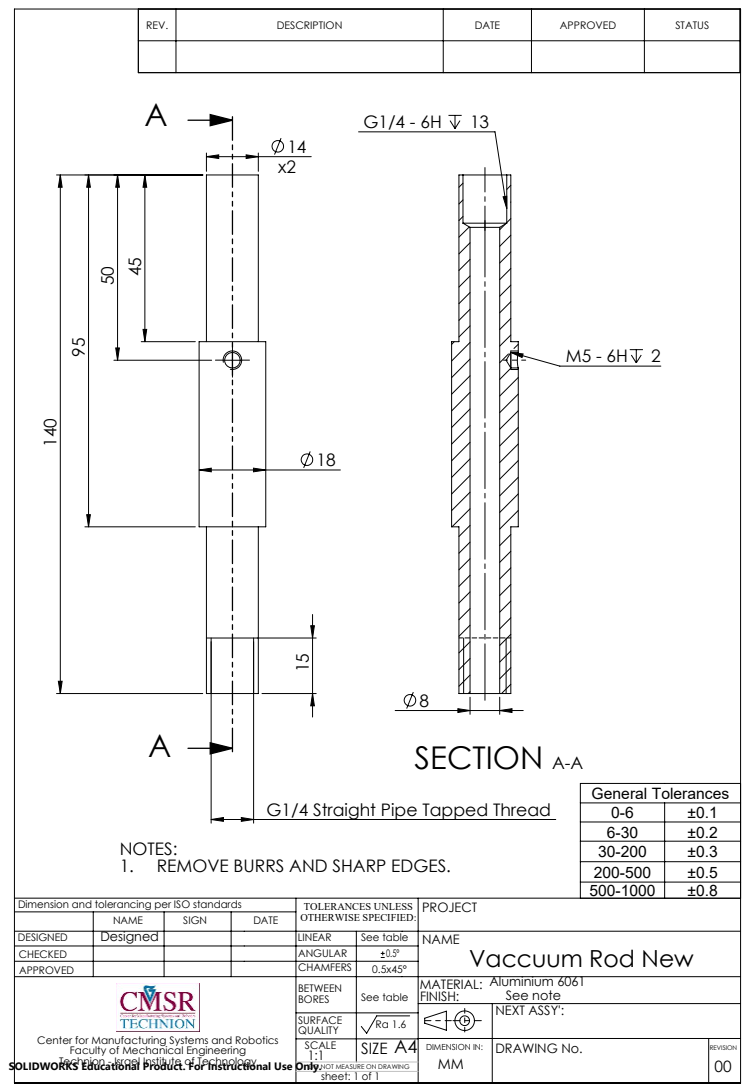
[picture p47: page 1]
SECTION A-A; General Tolerances; See table; See note; DIMENSION IN: DRAWING No.; TOLERANCES UNLESS OTHERWISE SPECIFIED:

G1/4 Straight Pipe Tapped Thread 15

0-6 | ±0.1
6-30 | ±0.2
30-200 | ±0.3
200-500 | ±0.5
500-1000 | ±0.8

NOTES:
1. REMOVE BURRS AND SHARP EDGES.

Dimension and tolerancing per ISO standards

PROJECT
NAME
Vaccuum Rod New
Aluminium 6061
NEXT ASSY':

Center for Manufacturing Systems and Robotics
Faculty of Mechanical Engineering
Technion - Israel Institute of Technology
SOLIDWORKS Educational Product. For Instructional Use Only.

SCALE
DO NOT MEASURE ON DRAWING
sheet: 1 of 1
