AlexanderFurman/Final-Project/Manufacturing/A4 Pulley Rod FINAL.pdf

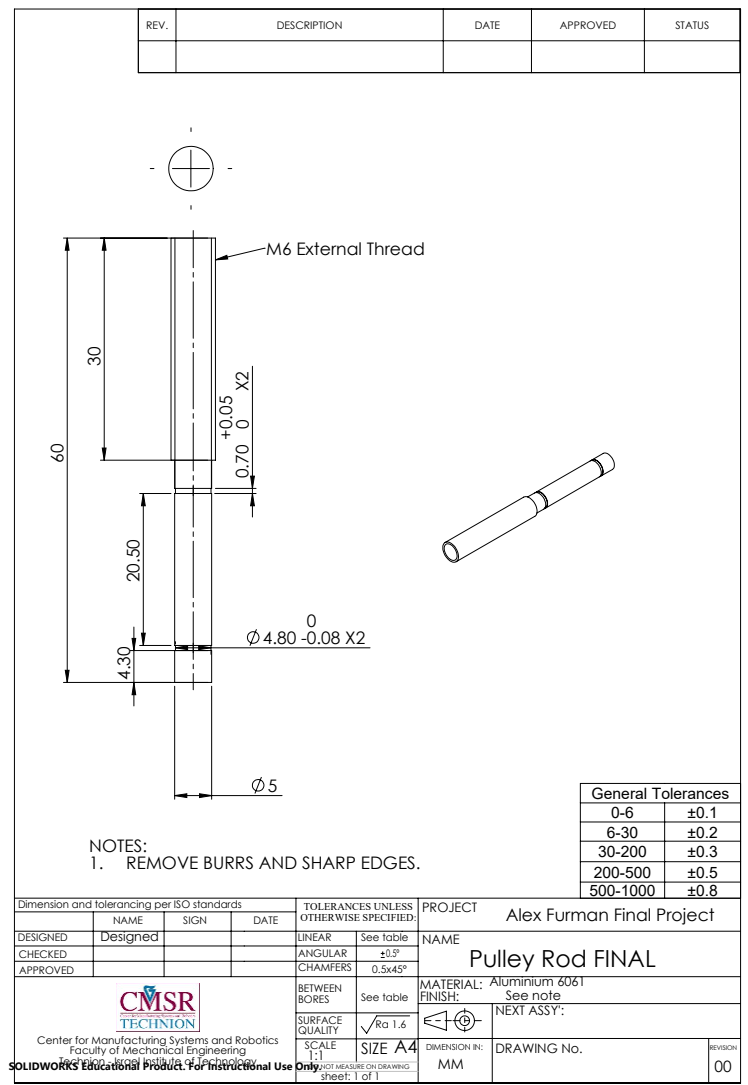
[picture p48: page 1]
M6 External Thread; General Tolerances; See table; See note; DIMENSION IN: DRAWING No.; TOLERANCES UNLESS OTHERWISE SPECIFIED:

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

NOTES:
1. REMOVE BURRS AND SHARP EDGES.

Dimension and tolerancing per ISO standards

PROJECT
NAME
Pulley Rod FINAL
Aluminium 6061
NEXT ASSY':

Alex Furman Final Project

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

SCALE
DO NOT MEASURE ON DRAWING
sheet: 1 of 1
