AlexanderFurman/Final-Project/Manufacturing/A4 Pulley Rod.pdf

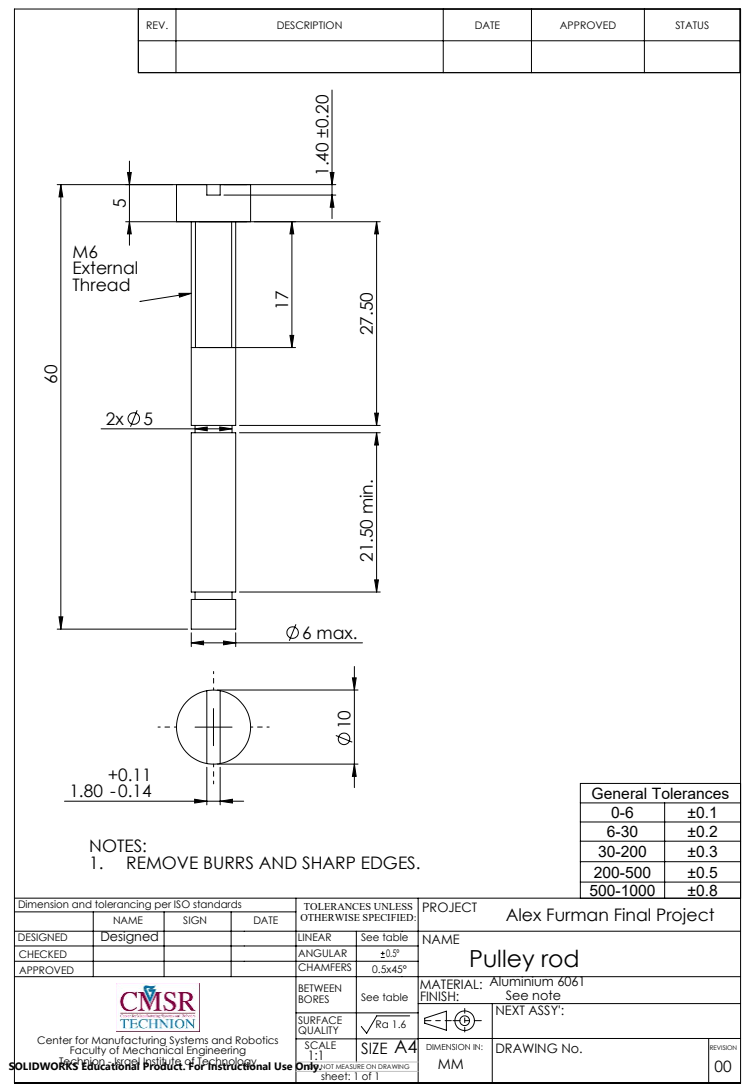
[picture p49: page 1]
6 max.; 21.50 min.; General Tolerances; See table; See note; Aluminium 6061; DIMENSION IN: DRAWING No.; NEXT ASSY':; TOLERANCES UNLESS OTHERWISE SPECIFIED:; Pulley rod

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

NOTES:
1. REMOVE BURRS AND SHARP EDGES.

Dimension and tolerancing per ISO standards

Alex Furman Final Project

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

SCALE
DO NOT MEASURE ON DRAWING
sheet: 1 of 1
