AlexanderFurman/Final-Project/Manufacturing/A3 Vacuum Rod.pdf

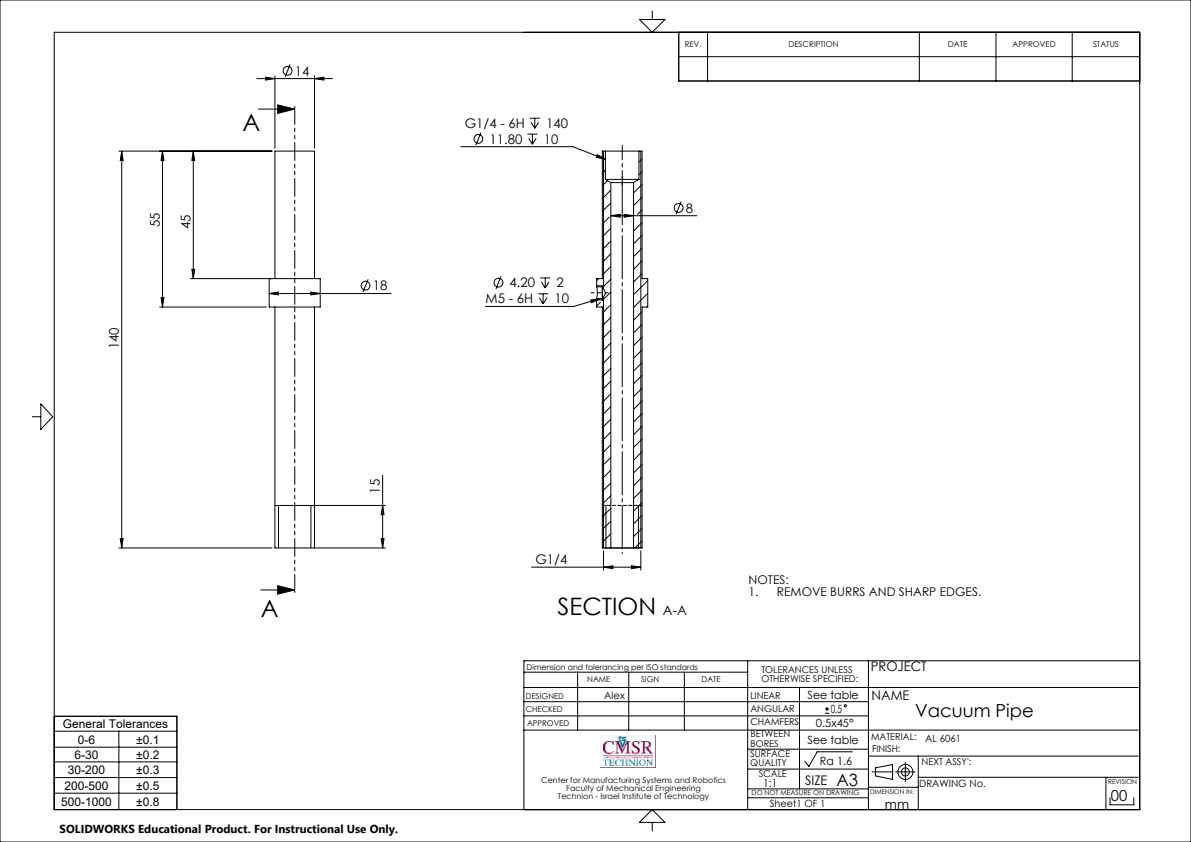
[picture p50: page 1]
SECTION A-A; General Tolerances; TOLERANCES UNLESS OTHERWISE SPECIFIED: See table; DO NOT MEASURE ON DRAWING; NEXT ASSY':; DRAWING No.; DIMENSION IN:; Sheet1 OF 1; See table; Vacuum Pipe

NOTES:
1. REMOVE BURRS AND SHARP EDGES.

Dimension and tolerancing per ISO standards

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

Center for Manufacturing Systems and Robotics
Faculty of Mechanical Engineering
Technion - Israel Institute of Technology

SOLIDWORKS Educational Product. For Instructional Use Only.
