AlexanderFurman/Final-Project/Manufacturing/Shaft with D-Bore.pdf

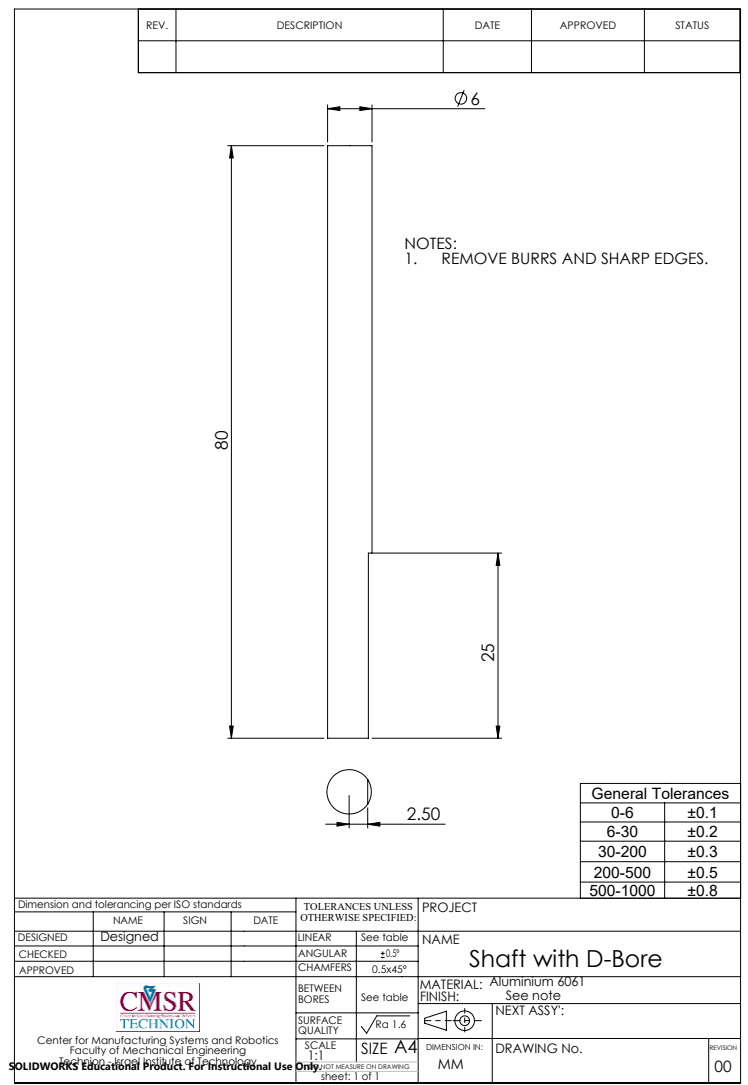
[picture p51: page 1]
General Tolerances; See table; See note; DIMENSION IN: DRAWING No.; TOLERANCES UNLESS OTHERWISE SPECIFIED:

NOTES:
1. REMOVE BURRS AND SHARP EDGES.

30-200 | ±0.3
200-500 | ±0.5
500-1000 | ±0.8

Dimension and tolerancing per ISO standards

PROJECT
NAME
Shaft with D-Bore
Aluminium 6061
NEXT ASSY':

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

SCALE
DO NOT MEASURE ON DRAWING
sheet: 1 of 1
