AlexanderFurman/Final-Project/(commit log)

2022-07-30 arduino code for gripper
2022-07-30 move_it commander for the robot arm
2022-07-30 Inverse Kinematics
